malloc-19/Neon-2/README.md

# Neon-2
3D Printer Controller

Licensed under CERN-OHL-S v2

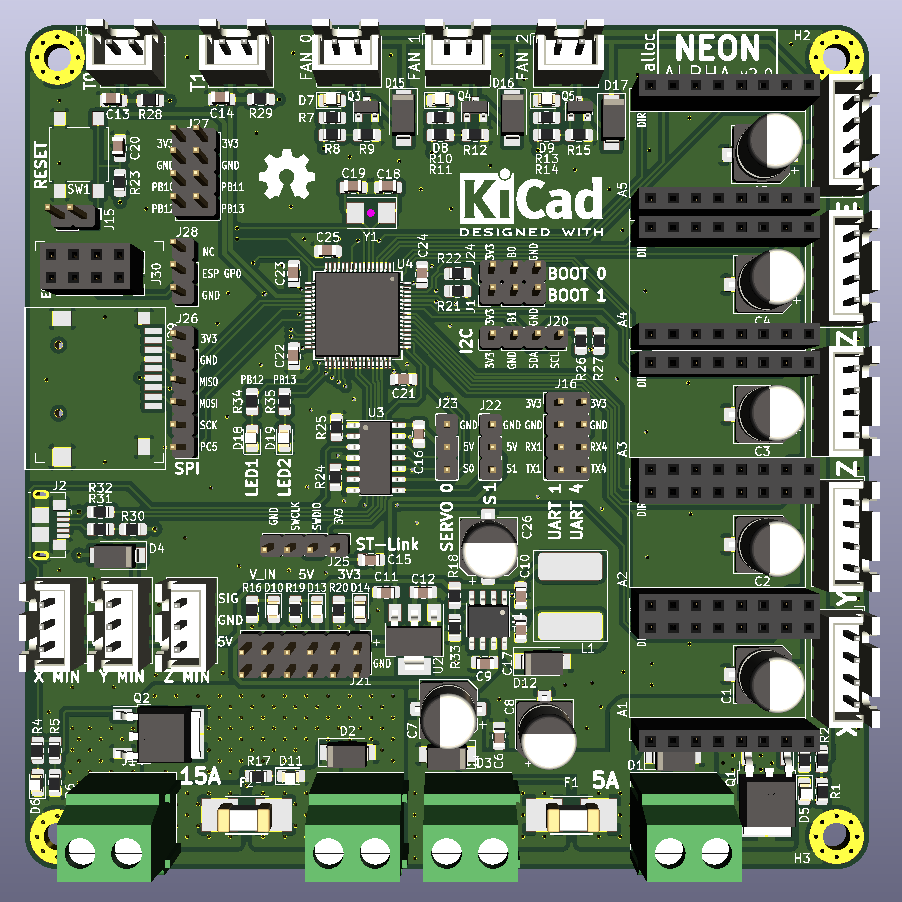
[picture p1: Neon v2.PNG]
Neon V2 image
