malloc-19/Neon-2/Neon v2 Schematic.pdf

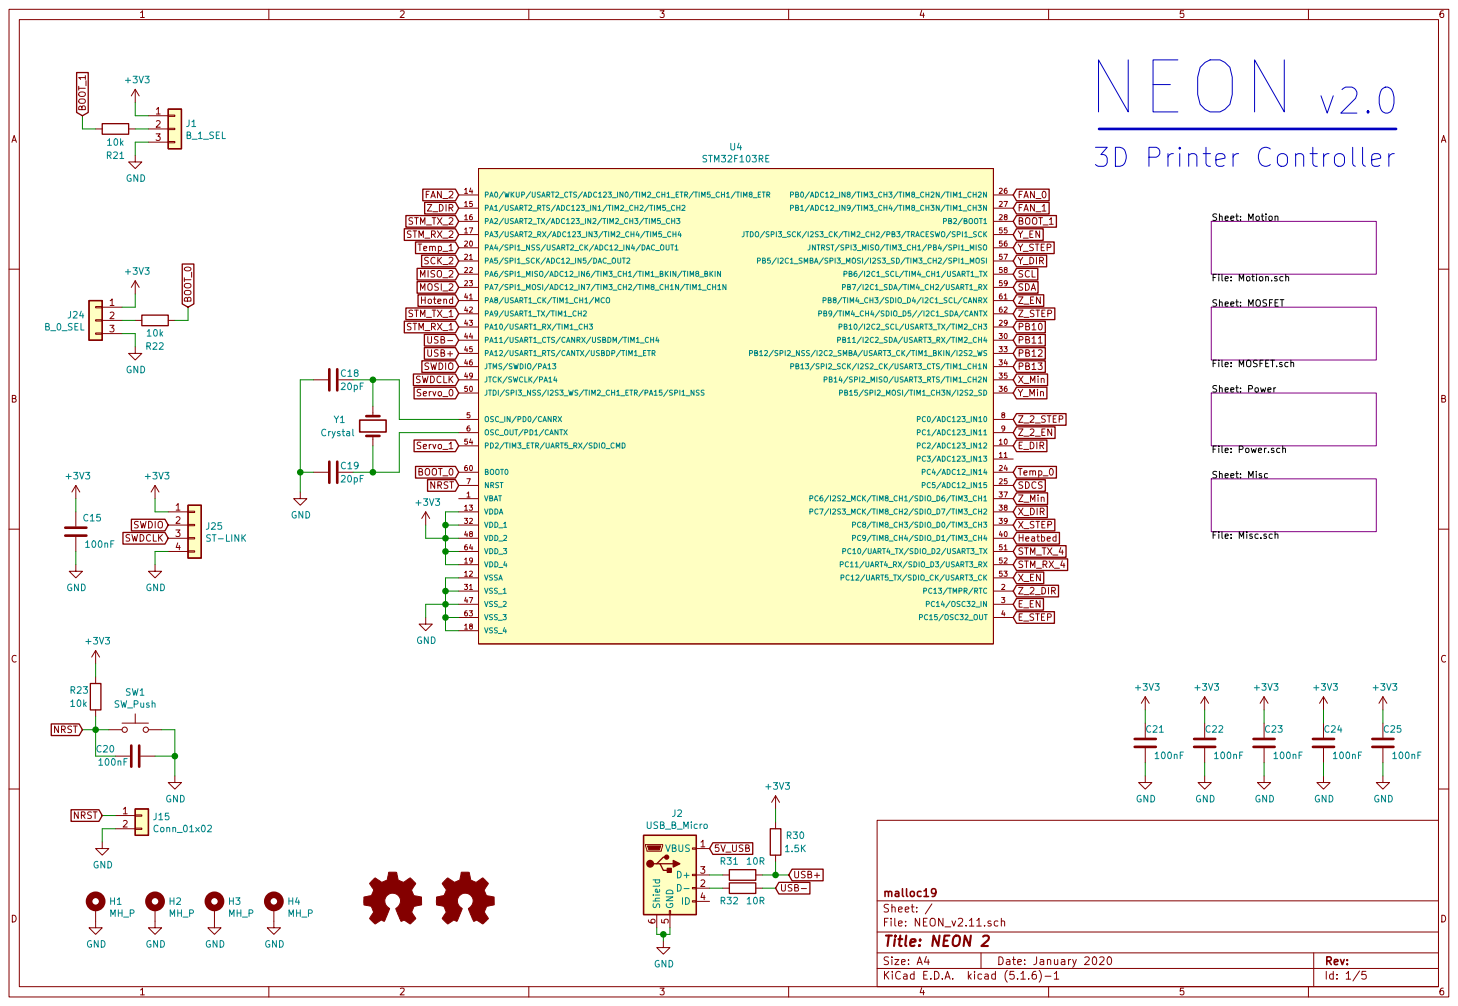
[picture p2: page 1]

Sheet: Motion File: Motion.sch Sheet: MOSFET

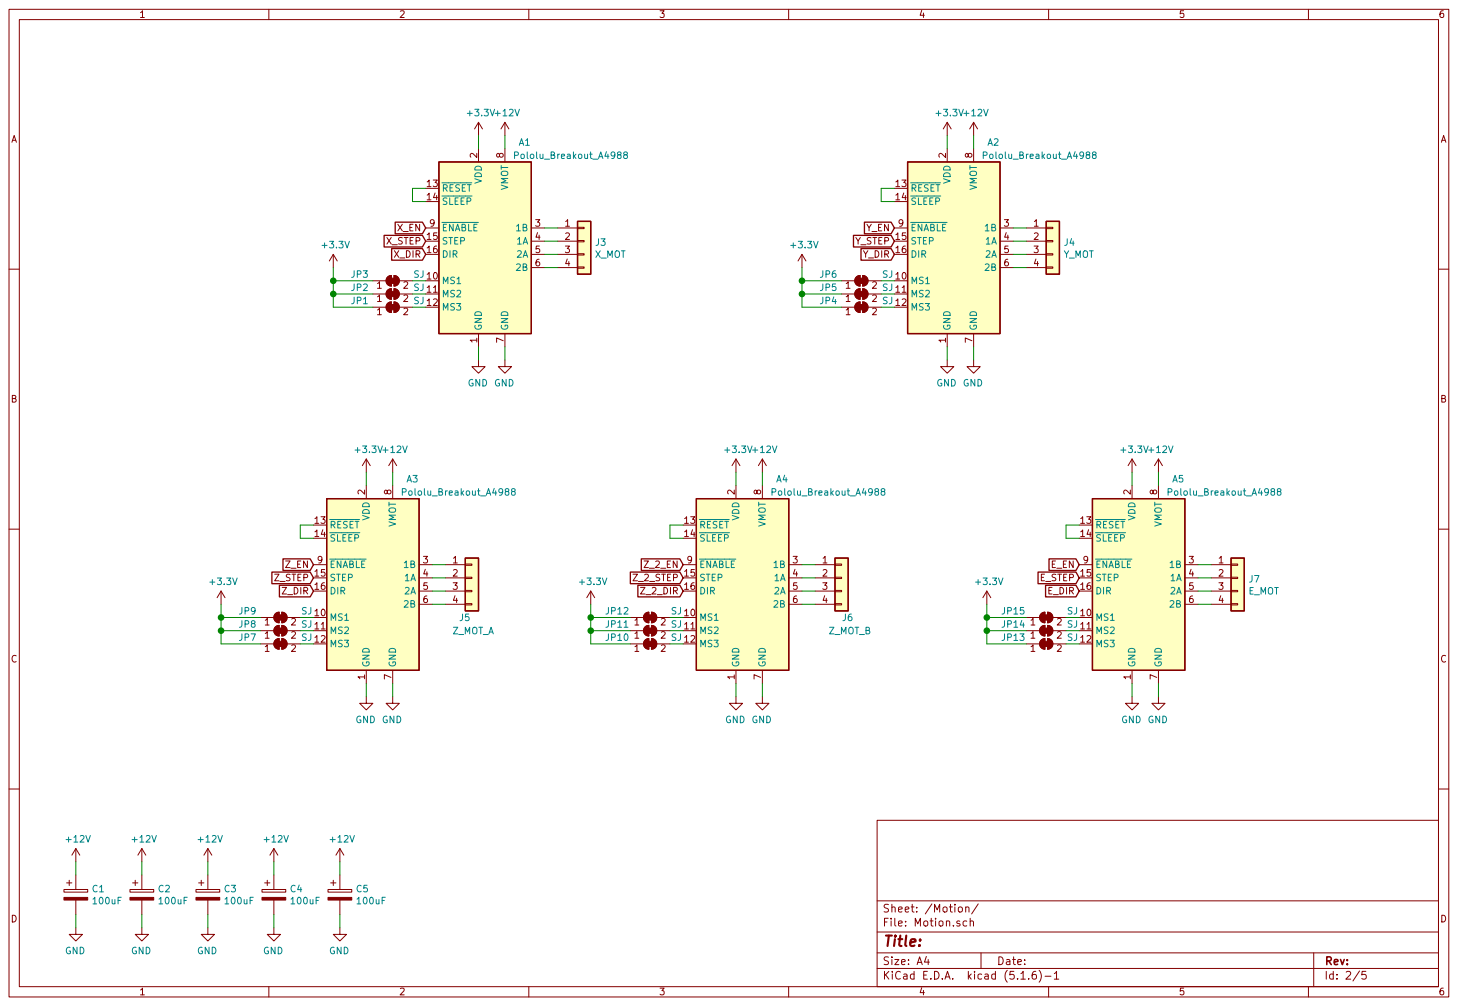
[picture p3: page 2]

8 ENABLE 9 A2 Pololu_Breakout_A4988 GND GND GND

1 MS1 10 MS2 11 MS3 12 RESET 13 SLEEP 14 STEP 15 DIR 16 VDD

8 ENABLE 9 A4 Pololu_Breakout_A4988 +3.3V +12V GND GND GND

8 ENABLE 9 A5 Pololu_Breakout_A4988 +3.3V +12V GND GND GND

Id: 2/5 Title: File: Motion.sch Sheet: /Motion/ C5

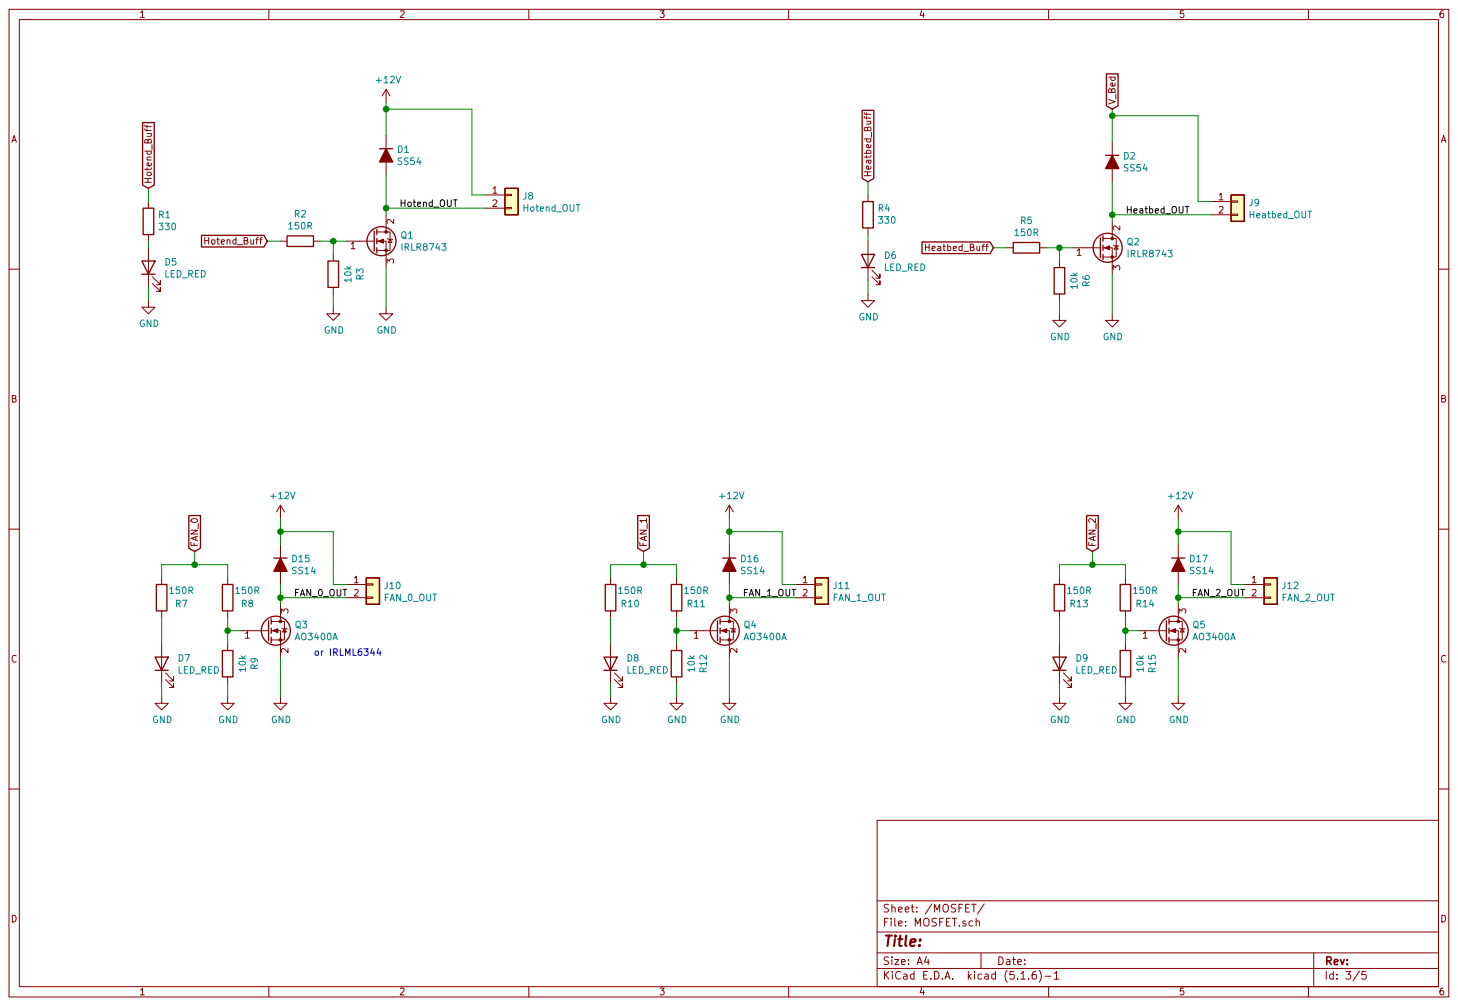
[picture p4: page 3]

Id: 3/5 Title: File: MOSFET.sch Sheet: /MOSFET/ 1

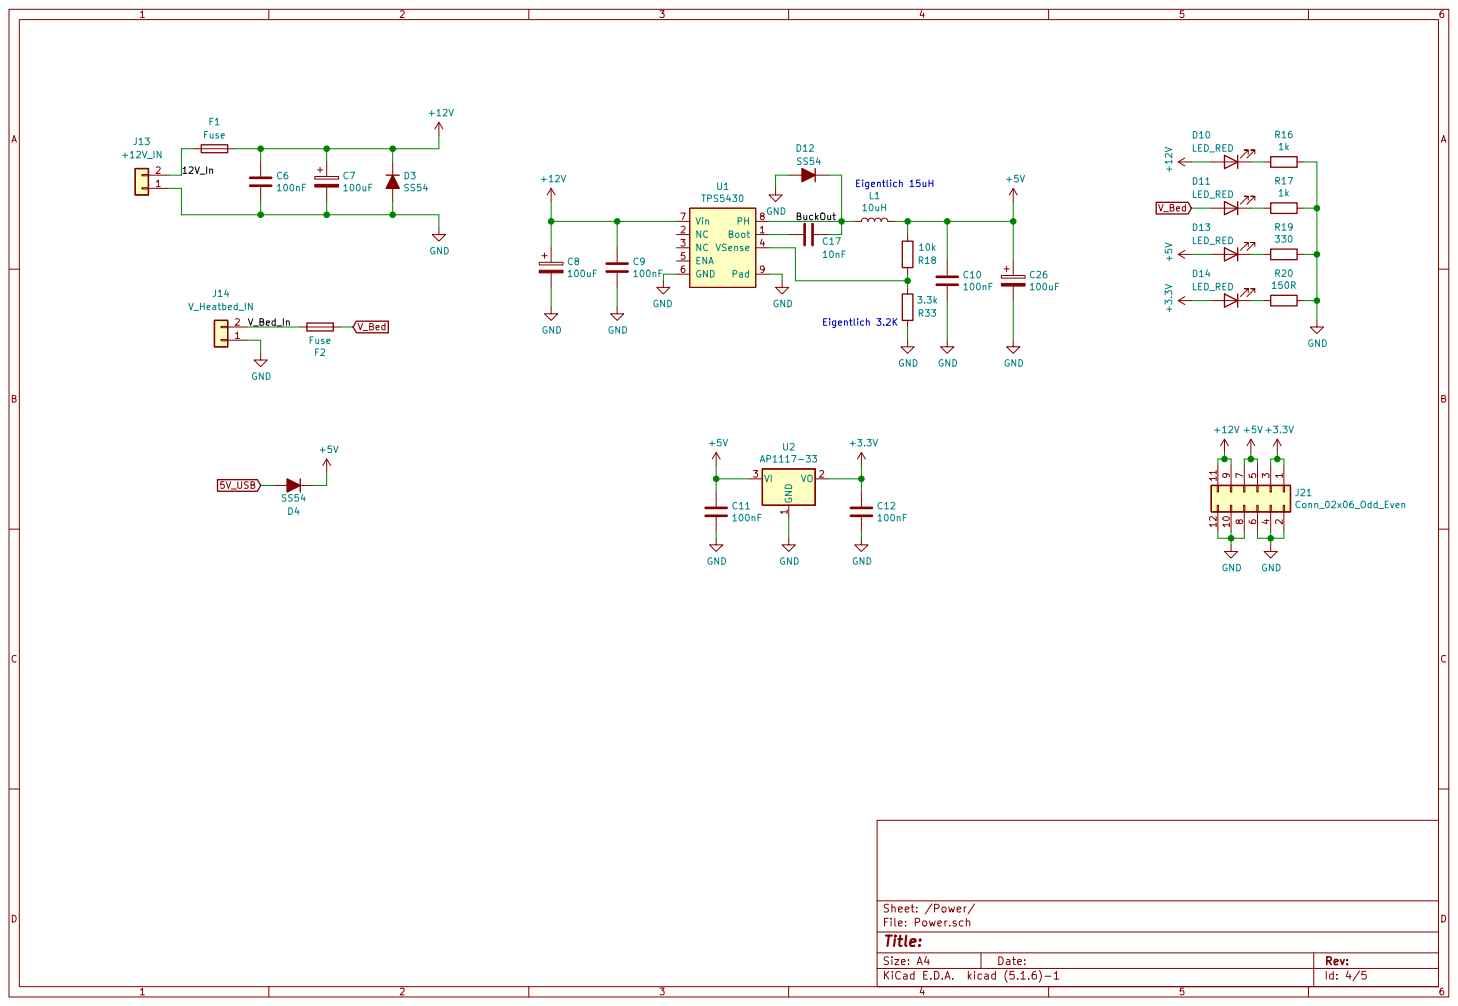
[picture p5: page 4]

Id: 4/5 Title: File: Power.sch Sheet: /Power/

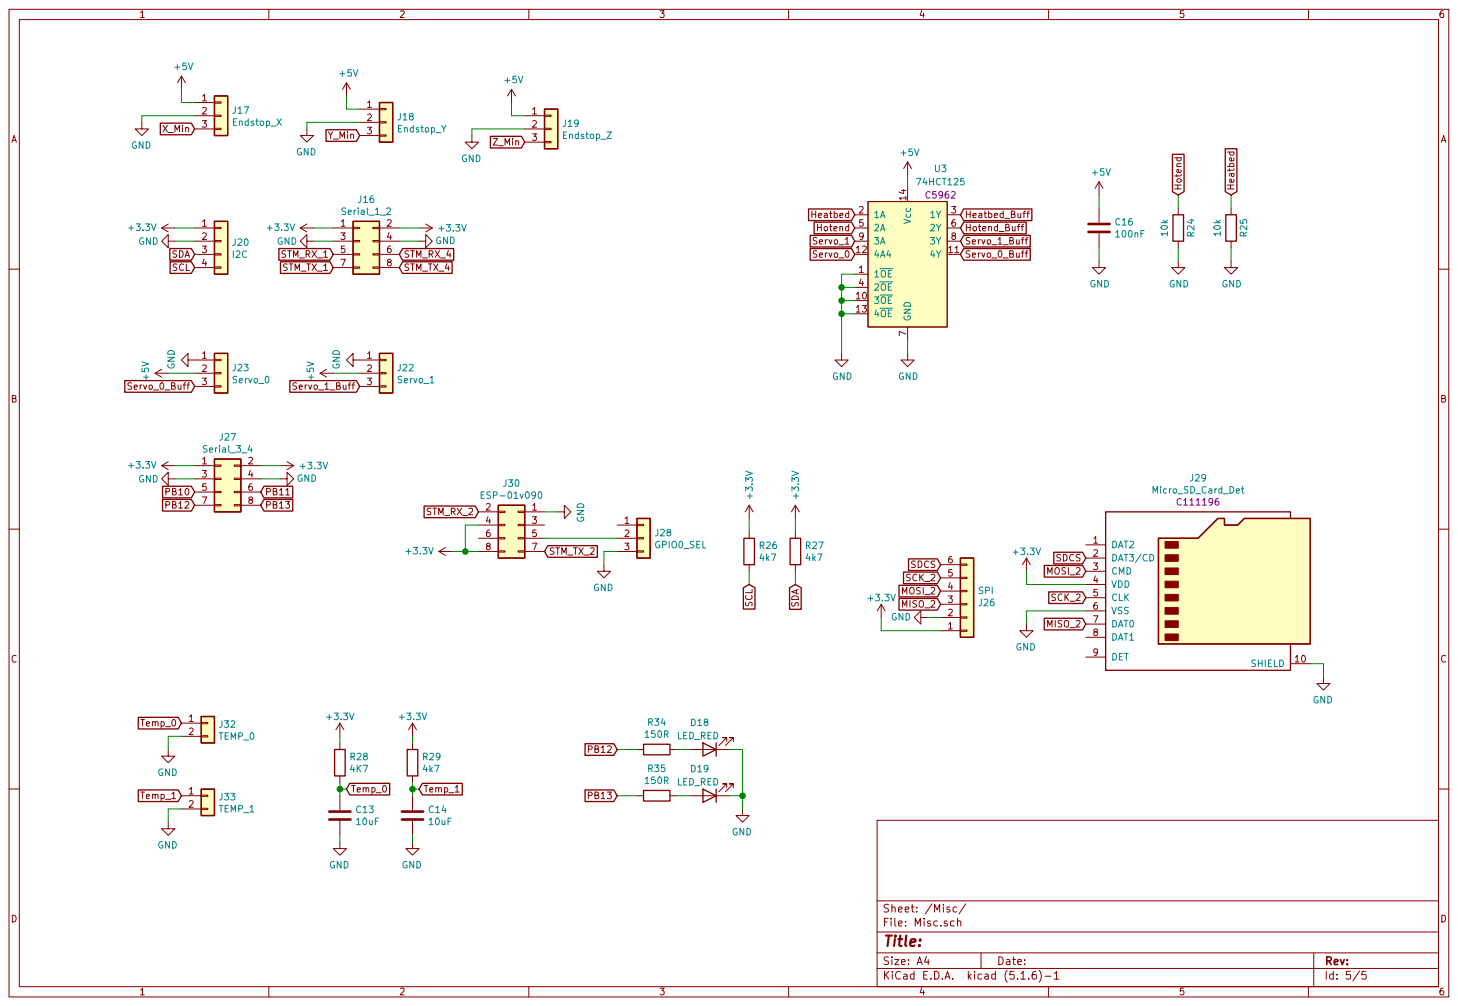
[picture p6: page 5]

Id: 5/5 Title: File: Misc.sch Sheet: /Misc/ 1
J32 TEMP_0
