malloc-19/Neon-2/MOSFET.sch

## KiCad design MOSFET.sch (2020-06-26)

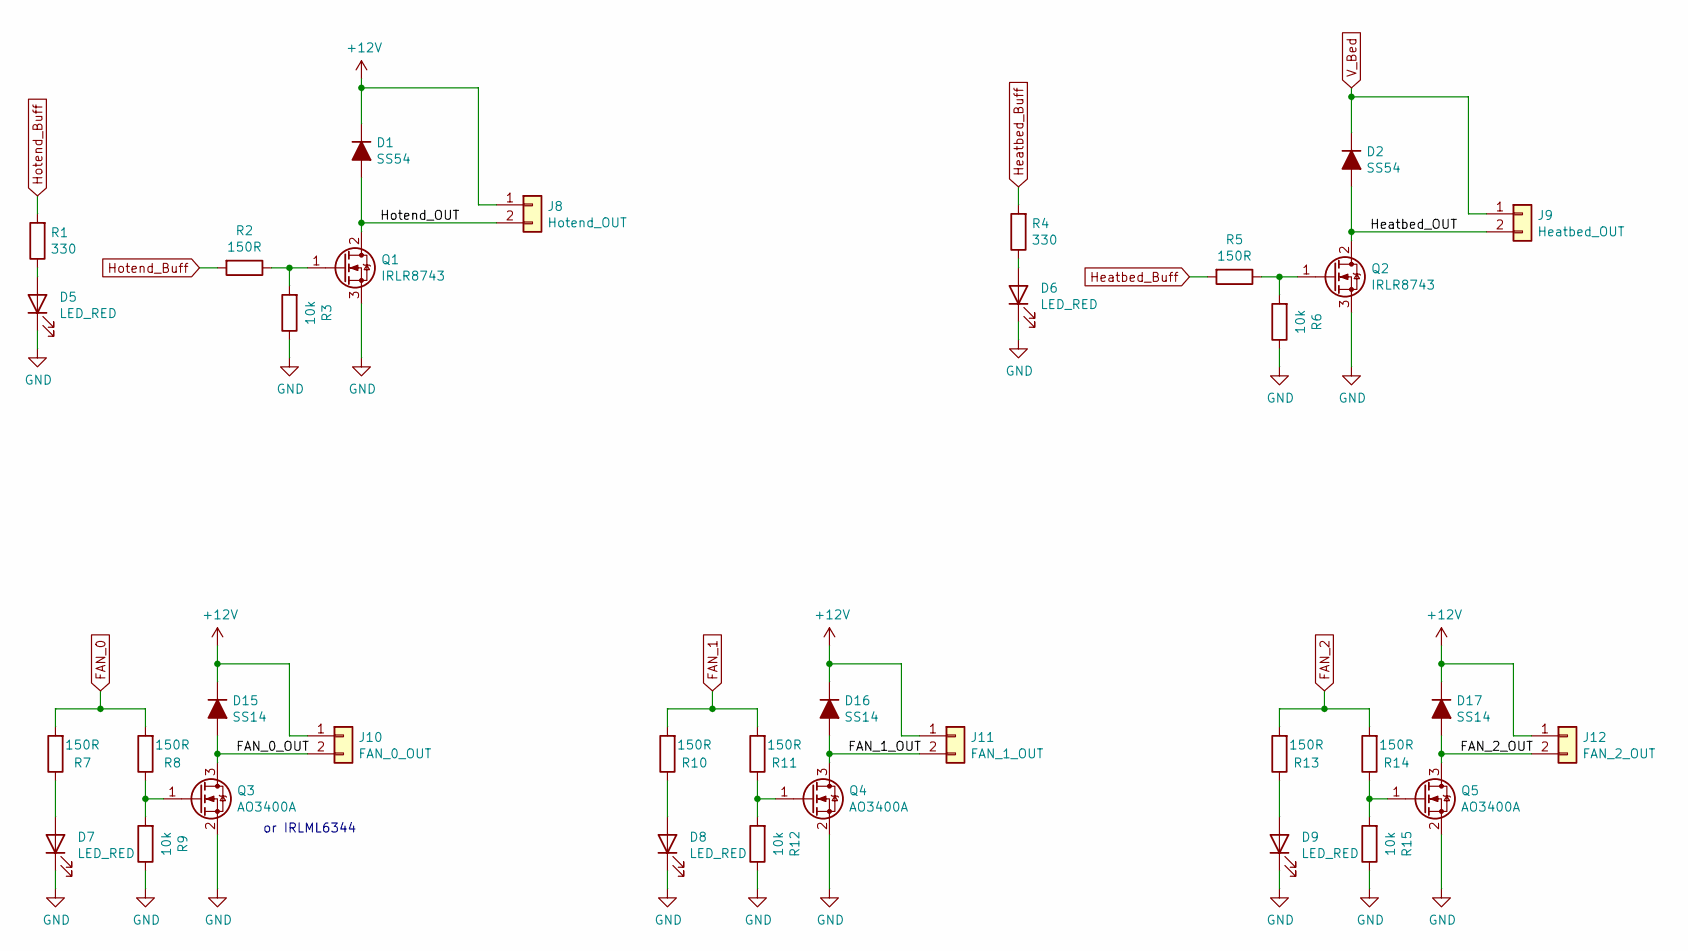
[picture p7: schematic MOSFET.sch]

Parts:
D1, D2: SS54; D_SMA; JLC C22452
D5, D6, D7, D8, D9: LED_RED; LED_0805_2012Metric_Pad1.15x1.40mm_HandSolder; JLC C84256
D15, D16, D17: SS14; D_SMA; JLC C2480
J8: Hotend_OUT; Dinkle_EK508V-02P; LCSC Part C8463
J9: Heatbed_OUT; Dinkle_EK508V-02P; LCSC Part C8463
J10: FAN_0_OUT; JST_XH_B2B-XH-A_1x02_P2.50mm_Vertical
J11: FAN_1_OUT; JST_XH_B2B-XH-A_1x02_P2.50mm_Vertical
J12: FAN_2_OUT; JST_XH_B2B-XH-A_1x02_P2.50mm_Vertical
Q1, Q2: IRLR8743; TO-252-2; JLC C51360
Q3, Q4, Q5: AO3400A; SOT-23; JLC C20917
R1, R4: 330; R_0805_2012Metric_Pad1.15x1.40mm_HandSolder; JLC C17630
R2, R5, R7, R8, R10, R11, R13, R14: 150R; R_0805_2012Metric_Pad1.15x1.40mm_HandSolder; JLC C17471
R3, R6, R9, R12, R15: 10k; R_0805_2012Metric_Pad1.15x1.40mm_HandSolder; JLC C17414

Connections:
+12V: D1.1 (K), D15.1 (K), D16.1 (K), D17.1 (K), J8.1, J10.1, J11.1, J12.1
FAN_0: R7.2, R8.2
FAN_0_OUT: D15.2 (A), J10.2, Q3.3 (D)
FAN_1: R10.2, R11.2
FAN_1_OUT: D16.2 (A), J11.2, Q4.3 (D)
FAN_2: R13.2, R14.2
FAN_2_OUT: D17.2 (A), J12.2, Q5.3 (D)
GND: D5.1 (K), D6.1 (K), D7.1 (K), D8.1 (K), D9.1 (K), Q1.3 (S), Q2.3 (S), Q3.2 (S), Q4.2 (S), Q5.2 (S), R3.1, R6.1, R9.1, R12.1, R15.1
Heatbed_Buff: R4.2, R5.2
Heatbed_OUT: D2.2 (A), J9.2, Q2.2 (D)
Hotend_Buff: R1.2, R2.2
Hotend_OUT: D1.2 (A), J8.2, Q1.2 (D)
unnamed: D5.2 (A), R1.1
unnamed: D6.2 (A), R4.1
unnamed: D7.2 (A), R7.1
unnamed: D8.2 (A), R10.1
unnamed: D9.2 (A), R13.1
unnamed: Q1.1 (G), R2.1, R3.2
unnamed: Q2.1 (G), R5.1, R6.2
unnamed: Q3.1 (G), R8.1, R9.2
unnamed: Q4.1 (G), R11.1, R12.2
unnamed: Q5.1 (G), R14.1, R15.2
V_Bed: D2.1 (K), J9.1

Notes on the sheet:
or IRLML6344
