malloc-19/Neon-2/Misc.sch

## KiCad design Misc.sch (2020-06-26)

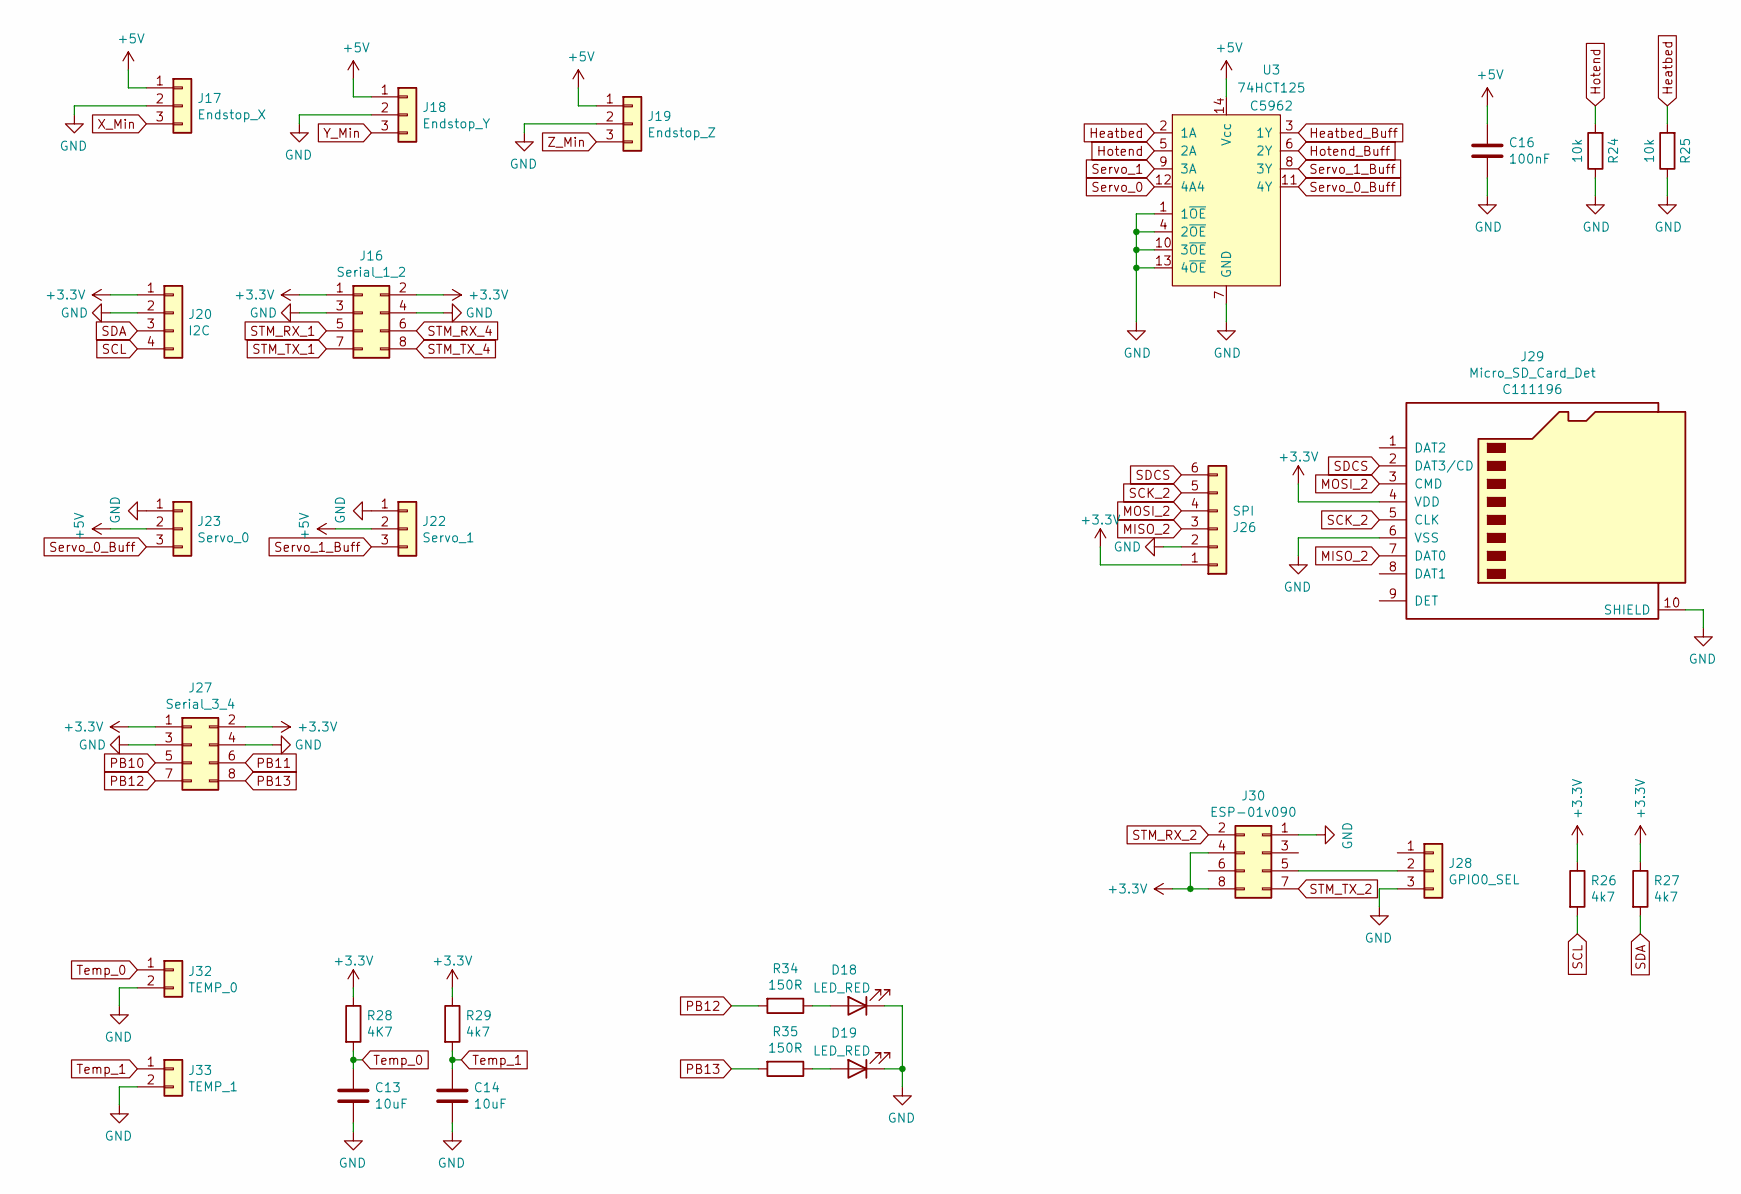
[picture p8: schematic Misc.sch]

Parts:
C13, C14: 10uF; C_0805_2012Metric_Pad1.15x1.40mm_HandSolder; JLC C15850
C16: 100nF; C_0805_2012Metric_Pad1.15x1.40mm_HandSolder; JLC C49678
D18, D19: LED_RED; LED_0805_2012Metric_Pad1.15x1.40mm_HandSolder; JLC C84256
J16: Serial_1_2; PinHeader_2x04_P2.54mm_Vertical
J17: Endstop_X; JST_XH_B3B-XH-A_1x03_P2.50mm_Vertical
J18: Endstop_Y; JST_XH_B3B-XH-A_1x03_P2.50mm_Vertical
J19: Endstop_Z; JST_XH_B3B-XH-A_1x03_P2.50mm_Vertical
J20: I2C; PinHeader_1x04_P2.54mm_Vertical
J22: Servo_1; PinHeader_1x03_P2.54mm_Vertical
J23: Servo_0; PinHeader_1x03_P2.54mm_Vertical
J26: SPI; PinHeader_1x06_P2.54mm_Vertical
J27: Serial_3_4; PinHeader_2x04_P2.54mm_Vertical
J28: GPIO0_SEL; PinHeader_1x03_P2.54mm_Vertical
J29: Micro_SD_Card_Det; MicroSD_Socket; LCSC Part C111196
J30: ESP-01v090; PinSocket_2x04_P2.54mm_Vertical
J32: TEMP_0; JST_XH_B2B-XH-A_1x02_P2.50mm_Vertical
J33: TEMP_1; JST_XH_B2B-XH-A_1x02_P2.50mm_Vertical
R24, R25: 10k; R_0805_2012Metric_Pad1.15x1.40mm_HandSolder; JLC C17414
R26, R27, R29: 4k7; R_0805_2012Metric_Pad1.15x1.40mm_HandSolder; JLC C17673
R28: 4K7; R_0805_2012Metric_Pad1.15x1.40mm_HandSolder; JLC C17673
R34, R35: 150R; R_0805_2012Metric_Pad1.15x1.40mm_HandSolder; JLC C17471
U3: 74HCT125; SOIC-14_3.9x8.7mm_P1.27mm; LCSC Part C5962

Connections:
+3.3V: J16.1, J16.2, J20.1, J26.1, J27.1, J27.2, J29.4 (VDD), J30.4, J30.8, R26.1, R27.1, R28.1, R29.1
+5V: C16.1, J17.1, J18.1, J19.1, J22.2, J23.2, U3.14 (Vcc)
GND: C13.2, C14.2, C16.2, D18.1 (K), D19.1 (K), J16.3, J16.4, J17.2, J18.2, J19.2, J20.2, J22.1, J23.1, J26.2, J27.3, J27.4, J28.3, J29.6 (VSS), J29.10 (SHIELD), J30.1, J32.2, J33.2, R24.1, R25.1, U3.1 (1~OE), U3.4 (2~OE), U3.7 (GND), U3.10 (3~OE), U3.13 (4~OE)
Heatbed: R25.2, U3.2 (1A)
Heatbed_Buff: U3.3 (1Y)
Hotend: R24.2, U3.5 (2A)
Hotend_Buff: U3.6 (2Y)
MISO_2: J26.3, J29.7 (DAT0)
MOSI_2: J26.4, J29.3 (CMD)
unnamed: D18.2 (A), R34.1
unnamed: D19.2 (A), R35.1
unnamed: J28.2, J30.5
PB10: J27.5
PB11: J27.6
PB12: J27.7, R34.2
PB13: J27.8, R35.2
SCK_2: J26.5, J29.5 (CLK)
SCL: J20.4, R26.2
SDA: J20.3, R27.2
SDCS: J26.6, J29.2 (DAT3/CD)
STM_RX_1: J16.5
STM_RX_2: J30.2
STM_RX_4: J16.6
STM_TX_1: J16.7
STM_TX_2: J30.7
STM_TX_4: J16.8
Servo_0: U3.12 (4A4)
Servo_0_Buff: J23.3, U3.11 (4Y)
Servo_1: U3.9 (3A)
Servo_1_Buff: J22.3, U3.8 (3Y)
Temp_0: C13.1, J32.1, R28.2
Temp_1: C14.1, J33.1, R29.2
X_Min: J17.3
Y_Min: J18.3
Z_Min: J19.3
