malloc-19/Neon-2/Motion.sch

## KiCad design Motion.sch (2020-06-26)

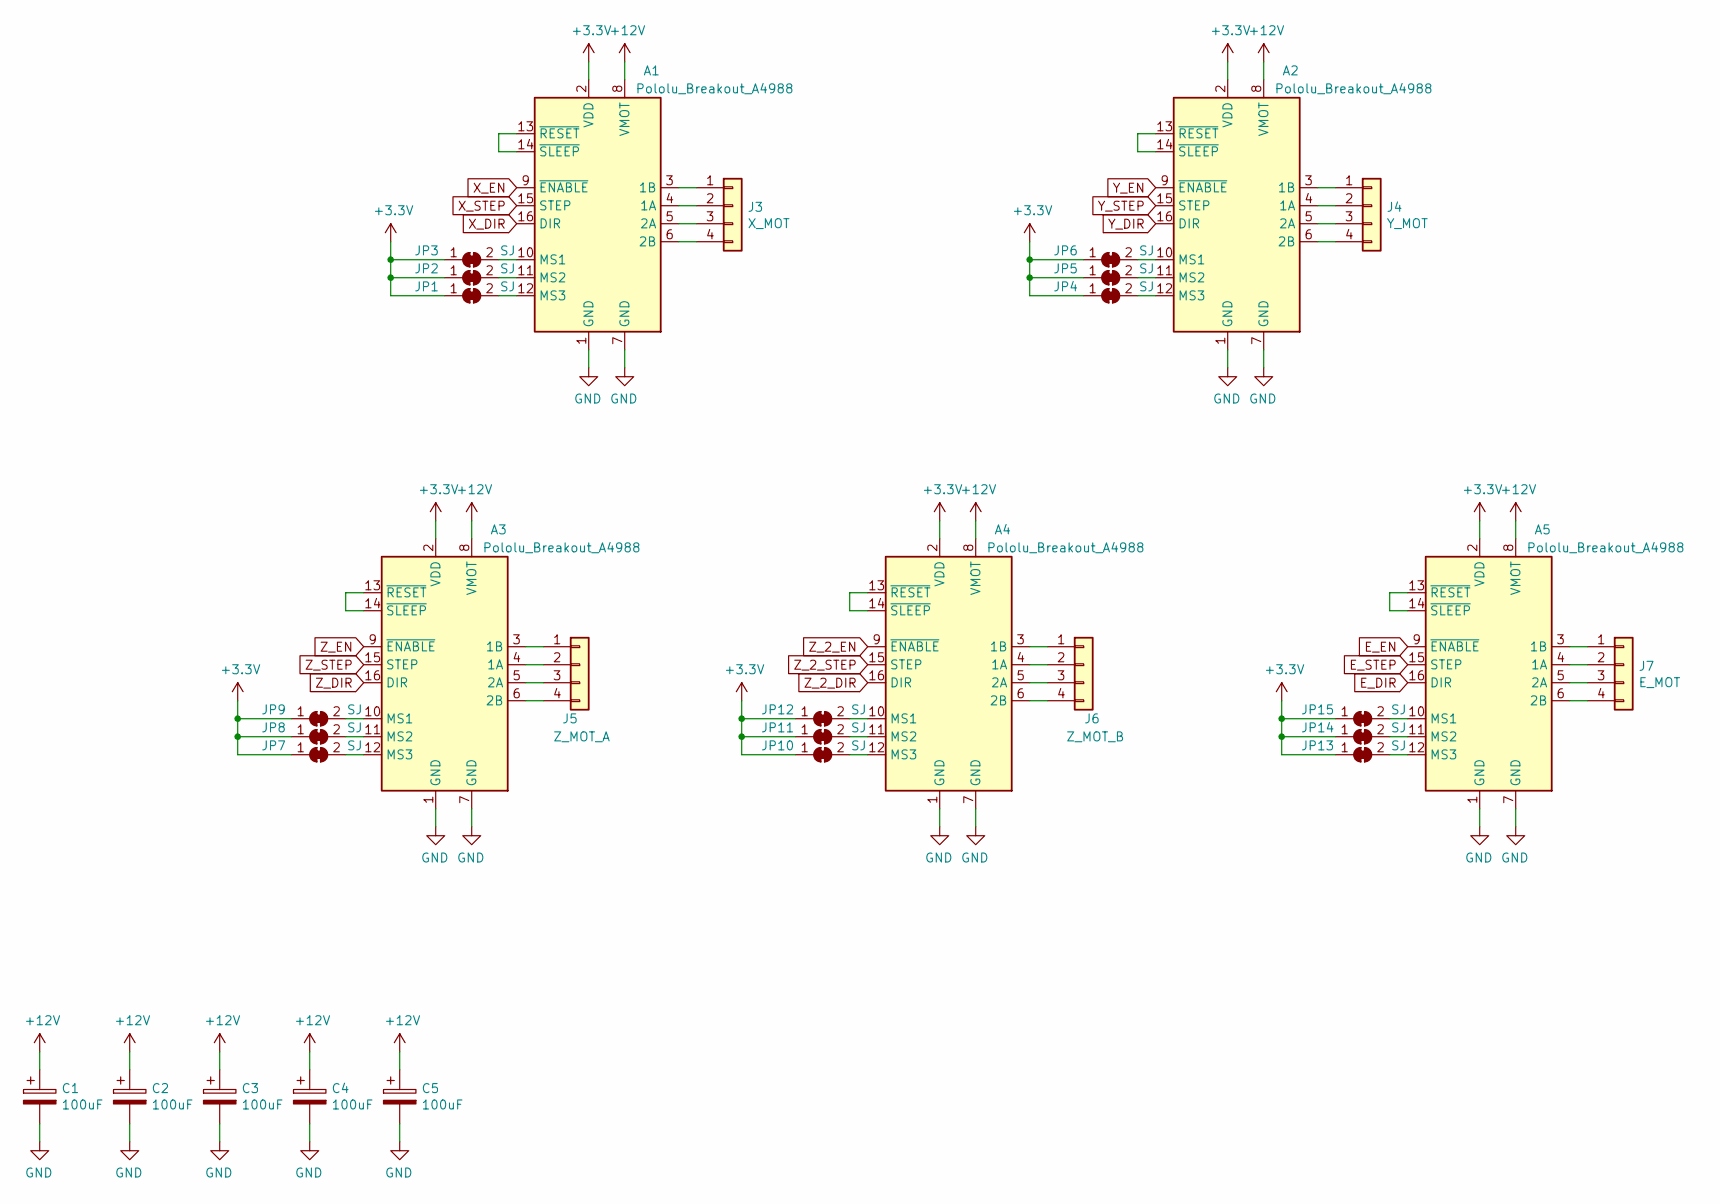
[picture p9: schematic Motion.sch]

Parts:
A1, A2, A3, A4, A5: Pololu_Breakout_A4988; Pololu_Breakout-16_15.2x20.3mm
C1, C2, C3, C4, C5: 100uF; CP_Elec_6.3x7.7; JLC C176666
J3: X_MOT; JST_XH_B4B-XH-A_1x04_P2.50mm_Vertical
J4: Y_MOT; JST_XH_B4B-XH-A_1x04_P2.50mm_Vertical
J5: Z_MOT_A; JST_XH_B4B-XH-A_1x04_P2.50mm_Vertical
J6: Z_MOT_B; JST_XH_B4B-XH-A_1x04_P2.50mm_Vertical
J7: E_MOT; JST_XH_B4B-XH-A_1x04_P2.50mm_Vertical
JP1, JP2, JP3, JP4, JP5, JP6, JP7, JP8, JP9, JP10, JP11, JP12, JP13, JP14, JP15: SJ; SolderJumper-2_P1.3mm_Bridged_RoundedPad1.0x1.5mm

Connections:
+3.3V: A1.2 (VDD), A2.2 (VDD), A3.2 (VDD), A4.2 (VDD), A5.2 (VDD), JP1.1 (A), JP2.1 (A), JP3.1 (A), JP4.1 (A), JP5.1 (A), JP6.1 (A), JP7.1 (A), JP8.1 (A), JP9.1 (A), JP10.1 (A), JP11.1 (A), JP12.1 (A), JP13.1 (A), JP14.1 (A), JP15.1 (A)
+12V: A1.8 (VMOT), A2.8 (VMOT), A3.8 (VMOT), A4.8 (VMOT), A5.8 (VMOT), C1.1, C2.1, C3.1, C4.1, C5.1
E_DIR: A5.16 (DIR)
E_EN: A5.9 (~ENABLE)
E_STEP: A5.15 (STEP)
GND: A1.1 (GND), A1.7 (GND), A2.1 (GND), A2.7 (GND), A3.1 (GND), A3.7 (GND), A4.1 (GND), A4.7 (GND), A5.1 (GND), A5.7 (GND), C1.2, C2.2, C3.2, C4.2, C5.2
unnamed: A1.3 (1B), J3.1
unnamed: A1.4 (1A), J3.2
unnamed: A1.5 (2A), J3.3
unnamed: A1.6 (2B), J3.4
unnamed: A1.10 (MS1), JP3.2 (B)
unnamed: A1.11 (MS2), JP2.2 (B)
unnamed: A1.12 (MS3), JP1.2 (B)
unnamed: A1.13 (~RESET), A1.14 (~SLEEP)
unnamed: A2.3 (1B), J4.1
unnamed: A2.4 (1A), J4.2
unnamed: A2.5 (2A), J4.3
unnamed: A2.6 (2B), J4.4
unnamed: A2.10 (MS1), JP6.2 (B)
unnamed: A2.11 (MS2), JP5.2 (B)
unnamed: A2.12 (MS3), JP4.2 (B)
unnamed: A2.13 (~RESET), A2.14 (~SLEEP)
unnamed: A3.3 (1B), J5.1
unnamed: A3.4 (1A), J5.2
unnamed: A3.5 (2A), J5.3
unnamed: A3.6 (2B), J5.4
unnamed: A3.10 (MS1), JP9.2 (B)
unnamed: A3.11 (MS2), JP8.2 (B)
unnamed: A3.12 (MS3), JP7.2 (B)
unnamed: A3.13 (~RESET), A3.14 (~SLEEP)
unnamed: A4.3 (1B), J6.1
unnamed: A4.4 (1A), J6.2
unnamed: A4.5 (2A), J6.3
unnamed: A4.6 (2B), J6.4
unnamed: A4.10 (MS1), JP12.2 (B)
unnamed: A4.11 (MS2), JP11.2 (B)
unnamed: A4.12 (MS3), JP10.2 (B)
unnamed: A4.13 (~RESET), A4.14 (~SLEEP)
unnamed: A5.3 (1B), J7.1
unnamed: A5.4 (1A), J7.2
unnamed: A5.5 (2A), J7.3
unnamed: A5.6 (2B), J7.4
unnamed: A5.10 (MS1), JP15.2 (B)
unnamed: A5.11 (MS2), JP14.2 (B)
unnamed: A5.12 (MS3), JP13.2 (B)
unnamed: A5.13 (~RESET), A5.14 (~SLEEP)
X_DIR: A1.16 (DIR)
X_EN: A1.9 (~ENABLE)
X_STEP: A1.15 (STEP)
Y_DIR: A2.16 (DIR)
Y_EN: A2.9 (~ENABLE)
Y_STEP: A2.15 (STEP)
Z_2_DIR: A4.16 (DIR)
Z_2_EN: A4.9 (~ENABLE)
Z_2_STEP: A4.15 (STEP)
Z_DIR: A3.16 (DIR)
Z_EN: A3.9 (~ENABLE)
Z_STEP: A3.15 (STEP)
