malloc-19/Neon-2/NEON_v2.11.sch

## KiCad design NEON_v2.11.sch (2020-08-26)

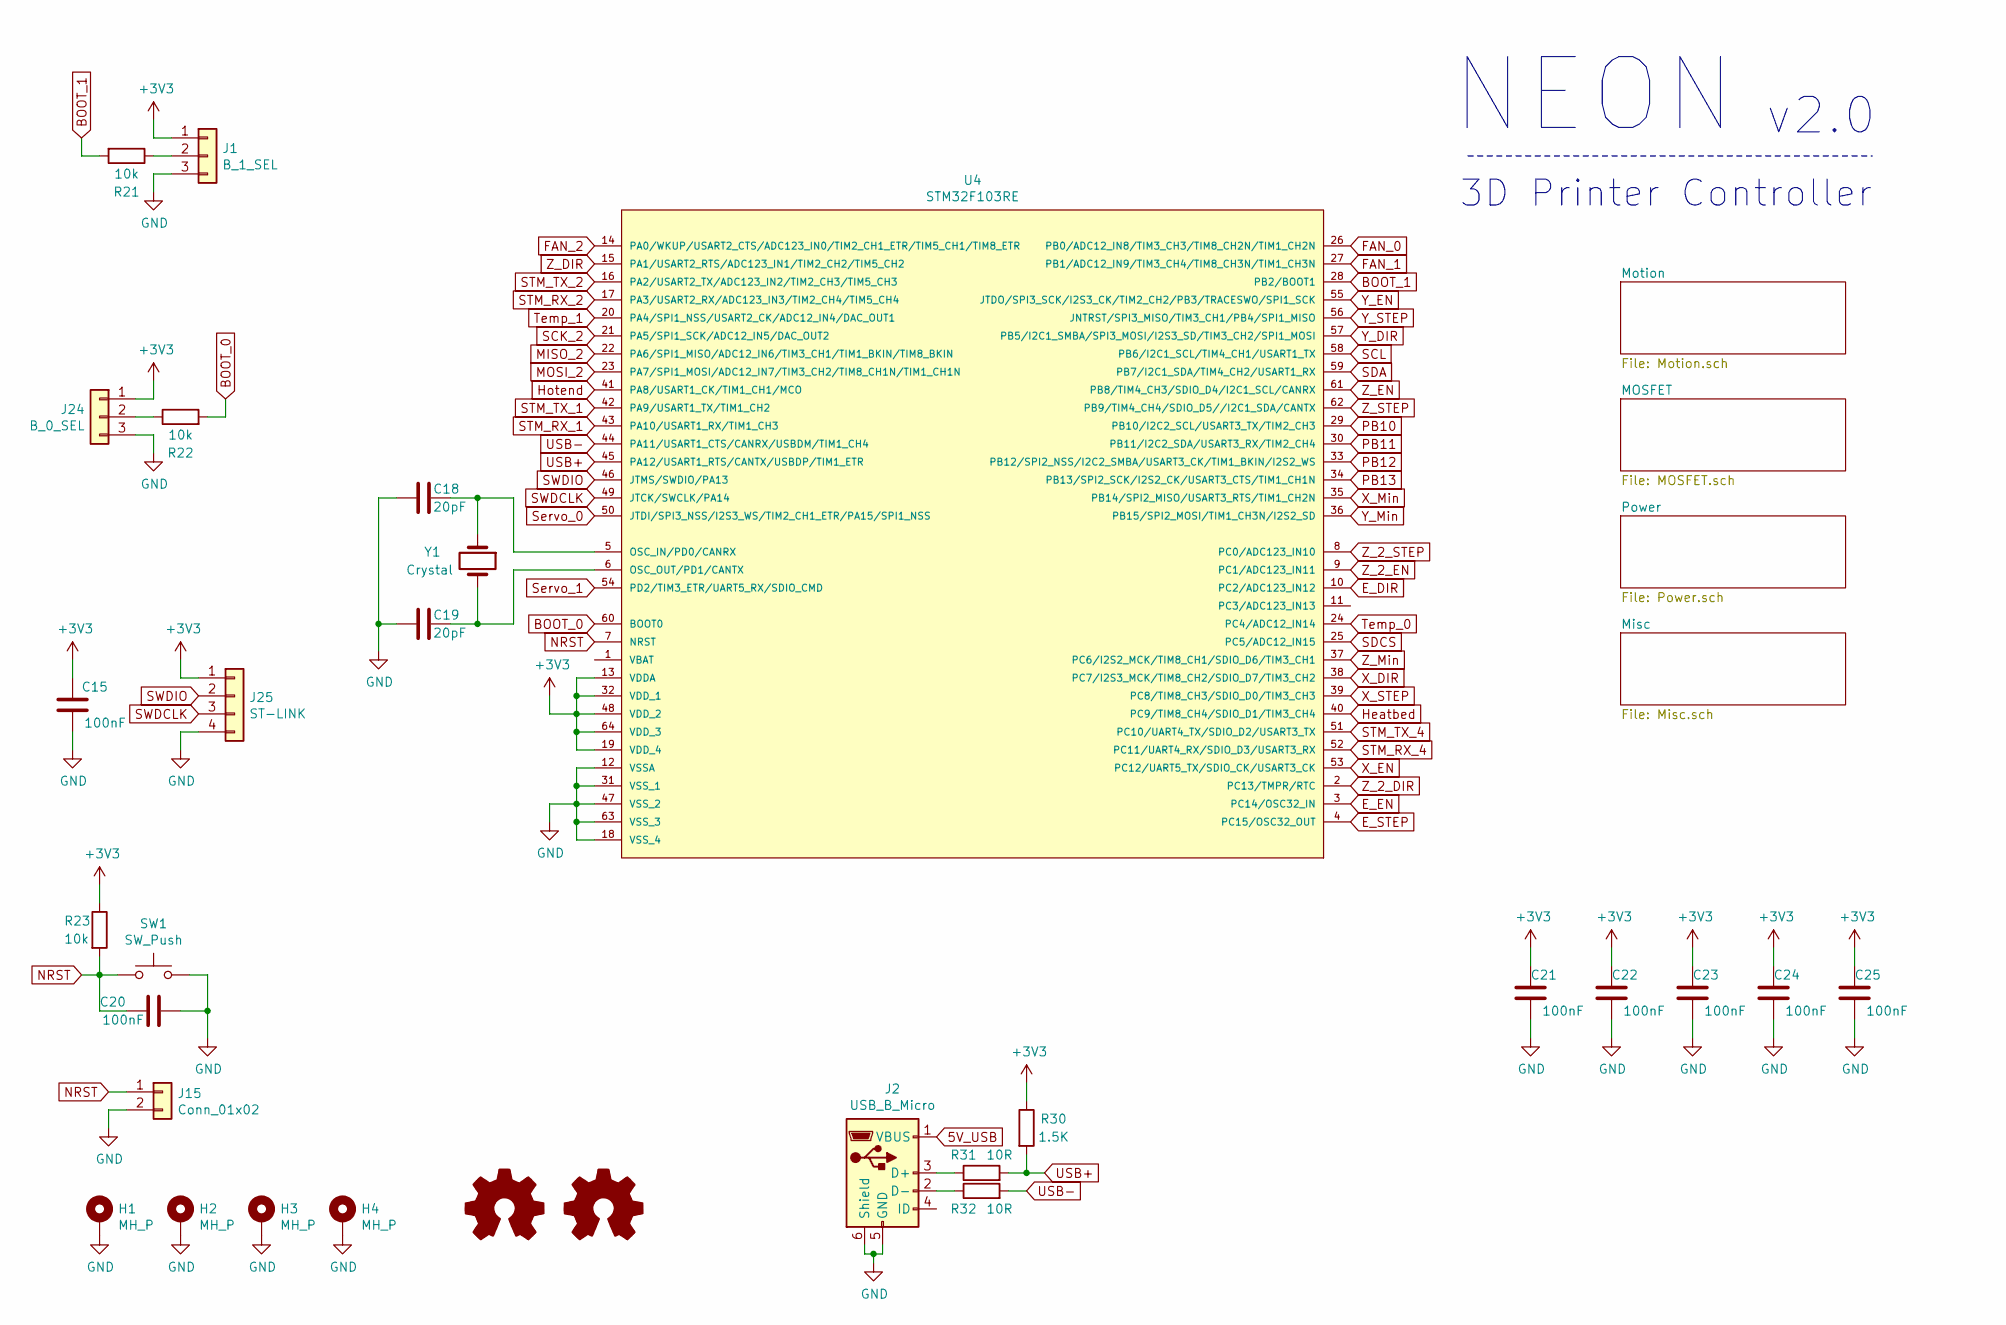
[picture p10: schematic NEON_v2.11.sch]

Parts:
C15, C20, C21, C22, C23, C24, C25: 100nF; C_0805_2012Metric_Pad1.15x1.40mm_HandSolder; JLC C49678
C18, C19: 20pF; C_0805_2012Metric_Pad1.15x1.40mm_HandSolder; JLC C1798
H1, H2, H3, H4: MH_P; MountingHole_3.2mm_M3_Pad_Via
J1: B_1_SEL; PinHeader_1x03_P2.54mm_Vertical
J2: USB_B_Micro; USB_Micro-B_GCT_USB3076-30-A
J15: Conn_01x02; PinHeader_1x02_P2.54mm_Vertical
J24: B_0_SEL; PinHeader_1x03_P2.54mm_Vertical
J25: ST-LINK; PinHeader_1x04_P2.54mm_Vertical
LOGO1: Logo_Open_Hardware_Small; OSHW-Symbol_6.7x6mm_SilkScreen
LOGO2: Logo_Open_Hardware_Small; KiCad-Logo2_8mm_SilkScreen
R21, R22, R23: 10k; R_0805_2012Metric_Pad1.15x1.40mm_HandSolder; JLC C17414
R30: 1.5K; R_0805_2012Metric_Pad1.15x1.40mm_HandSolder; JLC C4310
R31, R32: 10R; R_0805_2012Metric_Pad1.15x1.40mm_HandSolder; JLC C17415
SW1: SW_Push; Tactile_Switch_C255812
U4: STM32F103RE
Y1: Crystal; Crystal_SMD_5032-2Pin_5.0x3.2mm; JLC C115962

Connections:
5V_USB: J2.1 (VBUS)
+3V3: C15.2, C21.2, C22.2, C23.2, C24.2, C25.2, J1.1, J24.1, J25.1, R23.1, R30.1, U4.13 (VDDA), U4.19 (VDD_4), U4.32 (VDD_1), U4.48 (VDD_2), U4.64 (VDD_3)
BOOT_0: R22.2, U4.60 (BOOT0)
BOOT_1: R21.2, U4.28 (PB2/BOOT1)
E_DIR: U4.10 (PC2/ADC123_IN12)
E_EN: U4.3 (PC14/OSC32_IN)
E_STEP: U4.4 (PC15/OSC32_OUT)
FAN_0: U4.26 (PB0/ADC12_IN8/TIM3_CH3/TIM8_CH2N/TIM1_C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)
FAN_1: U4.27 (PB1/ADC12_IN9/TIM3_CH4/TIM8_CH3N/TIM1_C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)
FAN_2: U4.14 (PA0/WKUP/USART2_CTS/ADC123_IN0/TIM2_CH1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)
GND: C15.1, C18.2, C19.2, C20.2, C21.1, C22.1, C23.1, C24.1, C25.1, H1.1, H2.1, H3.1, H4.1, J1.3, J2.5 (GND), J2.6 (Shield), J15.2, J24.3, J25.4, SW1.2, U4.12 (VSSA), U4.18 (VSS_4), U4.31 (VSS_1), U4.47 (VSS_2), U4.63 (VSS_3)
Heatbed: U4.40 (PC9/TIM8_CH4/SDIO_D1/TIM3_CH4)
Hotend: U4.41 (PA8/USART1_CK/TIM1_CH1/MCO)
MISO_2: U4.22 (PA6/SPI1_MISO/ADC12_IN6/TIM3_CH1/TIM1_B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)
MOSI_2: U4.23 (PA7/SPI1_MOSI/ADC12_IN7/TIM3_CH2/TIM8_C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)
NRST: C20.1, J15.1, R23.2, SW1.1, U4.7 (NRST)
unnamed: C18.1, U4.5 (OSC_IN/PD0/CANRX), Y1.1
unnamed: C19.1, U4.6 (OSC_OUT/PD1/CANTX), Y1.2
unnamed: J1.2, R21.1
unnamed: J2.2 (D-), R32.1
unnamed: J2.3 (D+), R31.1
unnamed: J24.2, R22.1
PB10: U4.29 (PB10/I2C2_SCL/USART3_TX/TIM2_CH3)
PB11: U4.30 (PB11/I2C2_SDA/USART3_RX/TIM2_CH4)
PB12: U4.33 (PB12/SPI2_NSS/I2C2_SMBA/USART3_CK/TIM1_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)
PB13: U4.34 (PB13/SPI2_SCK/I2S2_CK/USART3_CTS/TIM1_C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)
SCK_2: U4.21 (PA5/SPI1_SCK/ADC12_IN5/DAC_OUT2)
SCL: U4.58 (PB6/I2C1_SCL/TIM4_CH1/USART1_TX)
SDA: U4.59 (PB7/I2C1_SDA/TIM4_CH2/USART1_RX)
SDCS: U4.25 (PC5/ADC12_IN15)
STM_RX_1: U4.43 (PA10/USART1_RX/TIM1_CH3)
STM_RX_2: U4.17 (PA3/USART2_RX/ADC123_IN3/TIM2_CH4/TIM5_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)
STM_RX_4: U4.52 (PC11/UART4_RX/SDIO_D3/USART3_RX)
STM_TX_1: U4.42 (PA9/USART1_TX/TIM1_CH2)
STM_TX_2: U4.16 (PA2/USART2_TX/ADC123_IN2/TIM2_CH3/TIM5_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)
STM_TX_4: U4.51 (PC10/UART4_TX/SDIO_D2/USART3_TX)
SWDCLK: J25.3, U4.49 (JTCK/SWCLK/PA14)
SWDIO: J25.2, U4.46 (JTMS/SWDIO/PA13)
Servo_0: U4.50 (JTDI/SPI3_NSS/I2S3_WS/TIM2_CH1_ETR/PA15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)
Servo_1: U4.54 (PD2/TIM3_ETR/UART5_RX/SDIO_CMD)
Temp_0: U4.24 (PC4/ADC12_IN14)
Temp_1: U4.20 (PA4/SPI1_NSS/USART2_CK/ADC12_IN4/DAC_OU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)
USB+: R30.2, R31.2, U4.45 (PA12/USART1_RTS/CANTX/USBDP/TIM1_ETR)
USB-: R32.2, U4.44 (PA11/USART1_CTS/CANRX/USBDM/TIM1_CH4)
X_DIR: U4.38 (PC7/I2S3_MCK/TIM8_CH2/SDIO_D7/TIM3_CH2)
X_EN: U4.53 (PC12/UART5_TX/SDIO_CK/USART3_CK)
X_Min: U4.35 (PB14/SPI2_MISO/USART3_RTS/TIM1_CH2N)
X_STEP: U4.39 (PC8/TIM8_CH3/SDIO_D0/TIM3_CH3)
Y_DIR: U4.57 (PB5/I2C1_SMBA/SPI3_MOSI/I2S3_SD/TIM3_CH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)
Y_EN: U4.55 (JTDO/SPI3_SCK/I2S3_CK/TIM2_CH2/PB3/TRAC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)
Y_Min: U4.36 (PB15/SPI2_MOSI/TIM1_CH3N/I2S2_SD)
Y_STEP: U4.56 (JNTRST/SPI3_MISO/TIM3_CH1/PB4/SPI1_MISO)
Z_2_DIR: U4.2 (PC13/TMPR/RTC)
Z_2_EN: U4.9 (PC1/ADC123_IN11)
Z_2_STEP: U4.8 (PC0/ADC123_IN10)
Z_DIR: U4.15 (PA1/USART2_RTS/ADC123_IN1/TIM2_CH2/TIM5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)
Z_EN: U4.61 (PB8/TIM4_CH3/SDIO_D4/I2C1_SCL/CANRX)
Z_Min: U4.37 (PC6/I2S2_MCK/TIM8_CH1/SDIO_D6/TIM3_CH1)
Z_STEP: U4.62 (PB9/TIM4_CH4/SDIO_D5//I2C1_SDA/CANTX)

Notes on the sheet:
NEON
v2.0
3D Printer Controller
