malloc-19/Neon-2/Power.sch

## KiCad design Power.sch (2020-08-26)

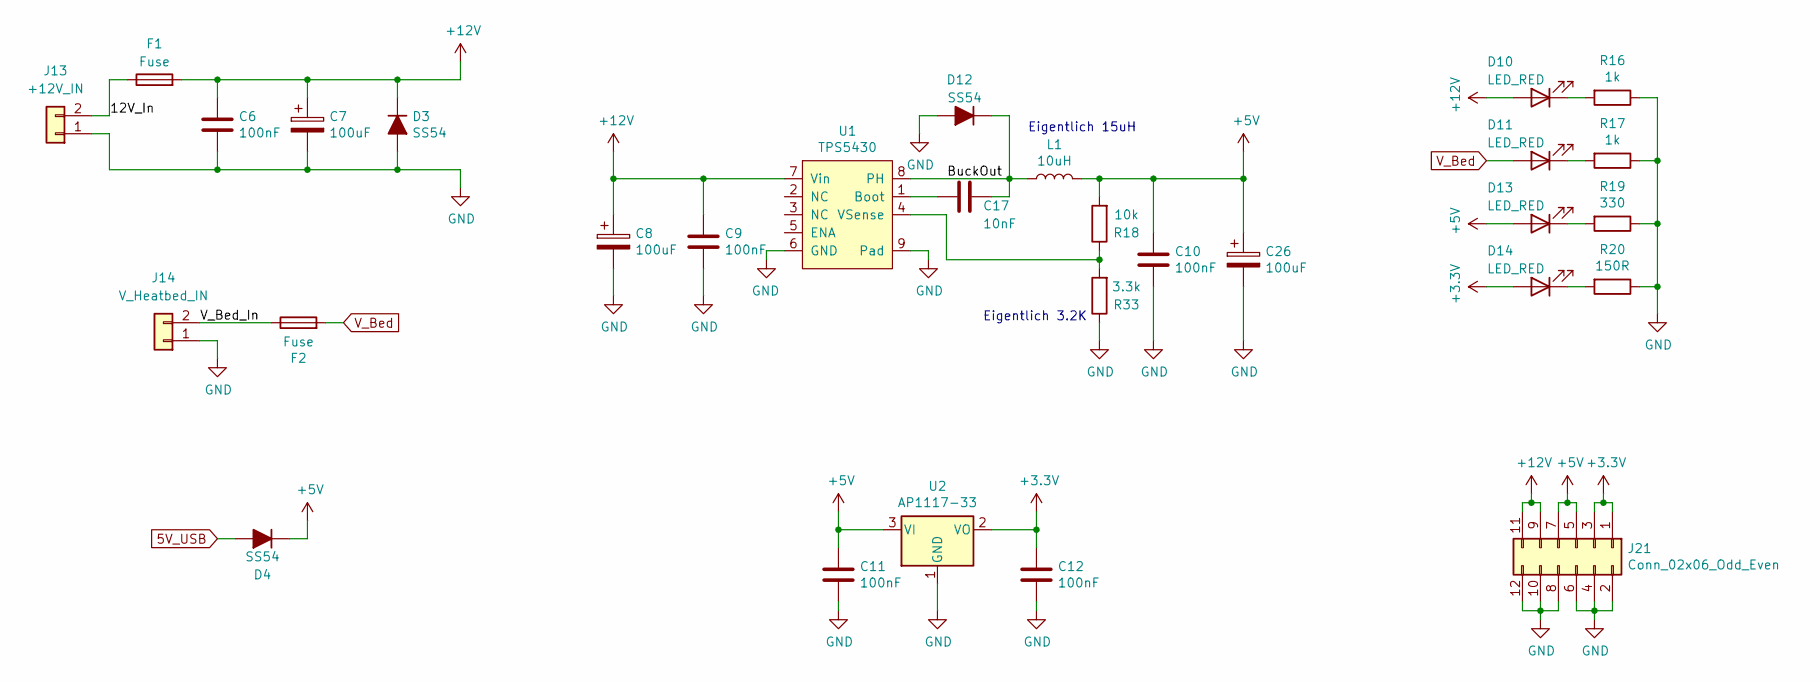
[picture p11: schematic Power.sch]

Parts:
C6, C9, C10, C11, C12: 100nF; C_0805_2012Metric_Pad1.15x1.40mm_HandSolder; JLC C49678
C7, C8, C26: 100uF; CP_Elec_6.3x7.7; JLC C176666
C17: 10nF; C_0805_2012Metric_Pad1.15x1.40mm_HandSolder; JLC C1710
D3, D4, D12: SS54; D_SMA; JLC C22452
D10, D11, D13, D14: LED_RED; LED_0805_2012Metric_Pad1.15x1.40mm_HandSolder; JLC C84256
F1, F2: Fuse; LF_451-453
J13: +12V_IN; Dinkle_EK508V-02P; LCSC Part C8463
J14: V_Heatbed_IN; Dinkle_EK508V-02P; LCSC Part C8463
J21: Conn_02x06_Odd_Even; PinHeader_2x06_P2.54mm_Vertical
L1: 10uH; SMNR8040-100MT__Inductor_HS
R16, R17: 1k; R_0805_2012Metric_Pad1.15x1.40mm_HandSolder; JLC C17513
R18: 10k; R_0805_2012Metric_Pad1.15x1.40mm_HandSolder; JLC C17414
R19: 330; R_0805_2012Metric_Pad1.15x1.40mm_HandSolder; JLC C17630
R20: 150R; R_0805_2012Metric_Pad1.15x1.40mm_HandSolder; JLC C17471
R33: 3.3k; R_0805_2012Metric_Pad1.15x1.40mm_HandSolder; JLC C26010
U1: TPS5430; SOIC-8-1EP_3.9x4.9mm_P1.27mm_EP2.41x3.3mm; JLC C9864
U2: AP1117-33; SOT-223-3_TabPin2; JLC C6186

Connections:
5V_USB: D4.2 (A)
12V_In: F1.1, J13.2
+3.3V: C12.1, D14.2 (A), J21.1, J21.3, U2.2 (VO)
+5V: C10.1, C11.1, C26.1, D4.1 (K), D13.2 (A), J21.5, J21.7, L1.2, R18.2, U2.3 (VI)
+12V: C6.1, C7.1, C8.1, C9.1, D3.1 (K), D10.2 (A), F1.2, J21.9, J21.11, U1.7 (Vin)
BuckOut: C17.1, D12.1 (K), L1.1, U1.8 (PH)
GND: C6.2, C7.2, C8.2, C9.2, C10.2, C11.2, C12.2, C26.2, D3.2 (A), D12.2 (A), J13.1, J14.1, J21.2, J21.4, J21.6, J21.8, J21.10, J21.12, R16.1, R17.1, R19.1, R20.1, R33.1, U1.6 (GND), U1.9 (Pad), U2.1 (GND)
unnamed: C17.2, U1.1 (Boot)
unnamed: D10.1 (K), R16.2
unnamed: D11.1 (K), R17.2
unnamed: D13.1 (K), R19.2
unnamed: D14.1 (K), R20.2
unnamed: R18.1, R33.2, U1.4 (VSense)
V_Bed: D11.2 (A), F2.2
V_Bed_In: F2.1, J14.2

Notes on the sheet:
Eigentlich 3.2K
Eigentlich 15uH
