malloc-19/Neon-2/(commit log)

2020-06-26 Initial Upload
    Added KiCad files
    [Connectivity.sch, MOSFET.sch, Misc.sch, Motion.sch, NEON_v2.11.sch, Power.sch, Trensfer.sch]
2020-06-26 Schematic Misc cleanup
    [Misc.sch]
2020-06-27 Updated MCU & Buck Library references
    [NEON_v2.11.sch, Power.sch]
